vinInvention/Agro-Smart-Hub/docs/Engineering_Reflection.md

# Engineering Reflection

Project: Agro-Smart Hub

---

# Introduction

The Agro-Smart Hub project was the most ambitious engineering project I had undertaken at the time of its development. It required me to combine concepts from mechanical engineering, electrical engineering, embedded systems, renewable energy, software development, and project management into a single working prototype.

Beyond building a functional system, the project challenged me to think like an engineer: identifying problems, evaluating alternatives, testing solutions, and continuously improving the design.

---

# Systems Thinking

One of the most significant lessons from this project was learning to view the prototype as a complete system rather than as individual components.

Although each subsystem could be designed and tested independently, their successful integration depended on careful consideration of how power, communication, mechanical motion, and material flow interacted with one another. This reinforced the importance of designing interfaces between subsystems rather than focusing solely on the performance of individual parts.

---

# Engineering Design

Throughout the project, I learned that engineering design is an iterative process.

Many of the initial ideas changed as new constraints emerged during construction and testing. Rather than viewing these changes as failures, I came to appreciate iteration as an essential part of engineering practice.

Each design revision improved either the reliability, manufacturability, or functionality of the prototype.

---

# Problem Solving

Several technical challenges required careful analysis before solutions could be implemented.

Rather than replacing components immediately when problems occurred, I learned the importance of systematic troubleshooting through observation, testing, and elimination of possible causes.

This approach proved valuable in resolving both mechanical and software-related issues throughout the project.

---

# Interdisciplinary Engineering

The Agro-Smart Hub reinforced my appreciation for interdisciplinary engineering.

Mechanical components depended on electrical power systems, electrical hardware depended on embedded software, and software decisions directly influenced mechanical behaviour.

Working across these disciplines strengthened my understanding of how mechatronic systems integrate multiple engineering fields into a unified solution.

---

# Leadership and Mentorship

Developing the project alongside secondary school students required balancing technical responsibilities with teaching and mentorship.

Breaking the project into manageable subsystems allowed students to understand complex engineering concepts while contributing meaningfully to the construction and testing of the prototype.

This experience strengthened my ability to communicate technical ideas clearly and to guide a multidisciplinary team toward a shared objective.

---

# Project Management

The project highlighted the importance of planning, budgeting, documentation, procurement, scheduling, and risk management.

Unexpected challenges frequently required adjustments to the original plan, reinforcing the need for flexibility while maintaining focus on the overall project objectives.

---

# Resilience

Not every challenge encountered during the project had a technical cause.

Equipment loss, component failures, and time constraints affected progress and required continual adaptation.

These experiences reinforced the importance of resilience, preparation, and maintaining progress despite unforeseen setbacks.

---

# Future Development

If I were to redesign the Agro-Smart Hub, I would focus on improving system reliability, modularity, and maintainability.

Potential improvements include enhanced battery management, closed-loop control using sensors, improved wireless communication, autonomous operation, and computer vision for process monitoring.

---

# Conclusion

The Agro-Smart Hub project transformed my understanding of engineering from assembling individual components to designing integrated systems that solve real-world problems.

More importantly, it strengthened my confidence in approaching unfamiliar engineering challenges through structured analysis, experimentation, and continuous improvement. The experience has further motivated me to pursue advanced studies in mechatronics engineering, where I hope to deepen my knowledge and contribute to the development of intelligent engineering systems.
