vinInvention/Agro-Smart-Hub/assets/truck/Truck and L293D Motor driver  connection.pdf

Here are images on how to connect your motor to the motor driver shield

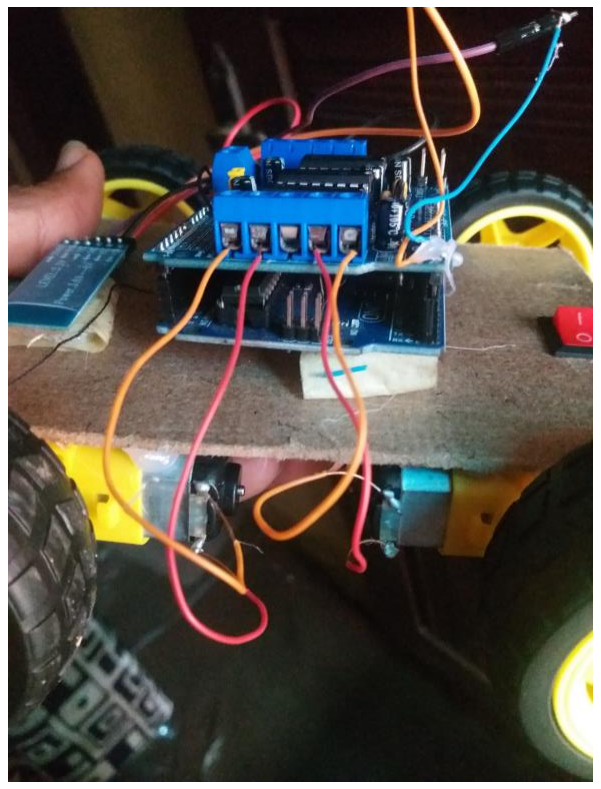
[picture p23: figure]
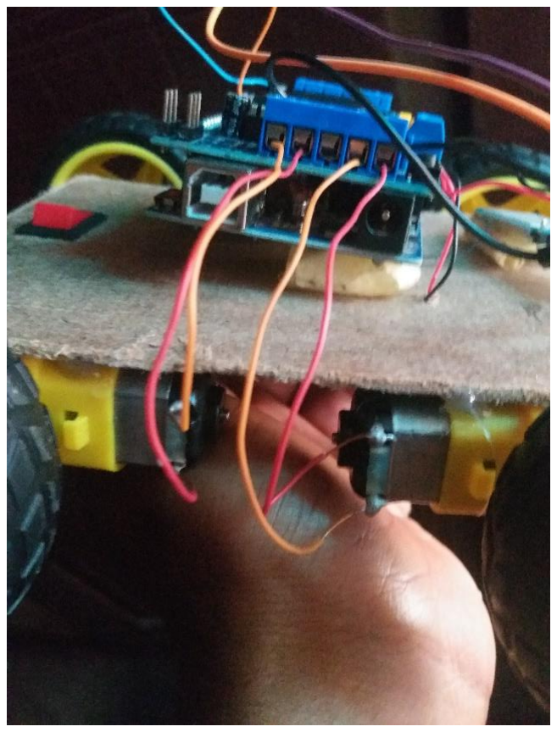
[picture p24: figure]

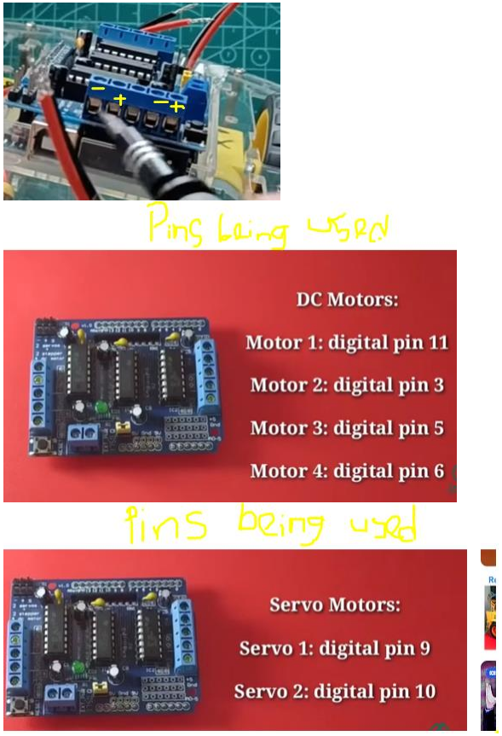
[picture p25: figure]

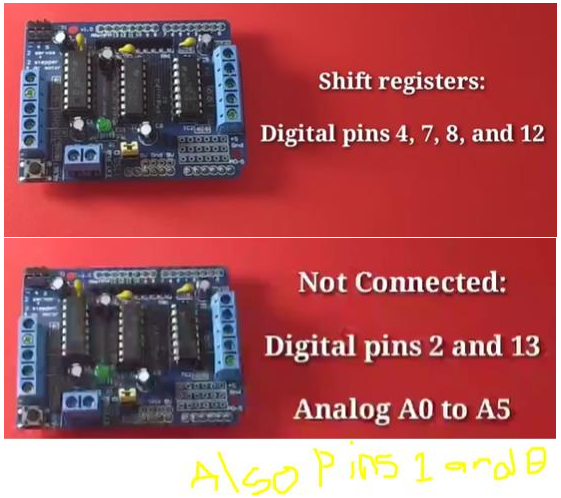
[picture p26: figure]
