vinInvention/Agro-Smart-Hub/assets/2. Units built.jpg

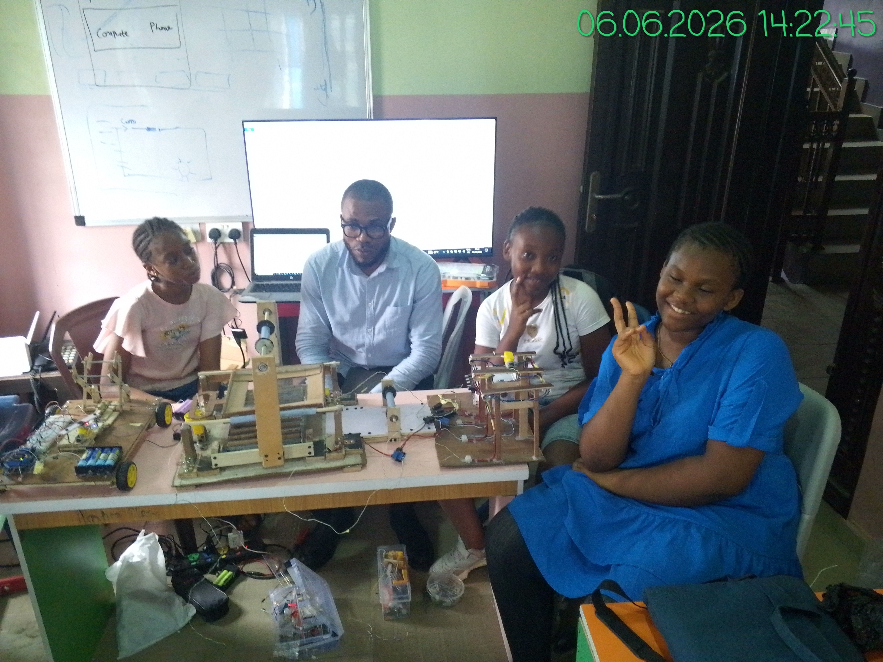
assets/2. Units built.jpg
