vinInvention/Agro-Smart-Hub/assets/Assignments for my student/Calculate the power of the load.PNG

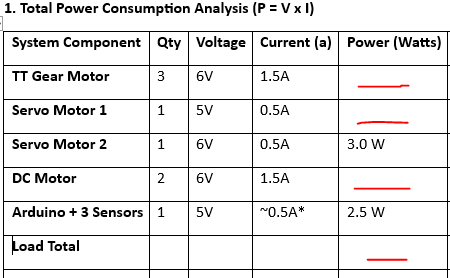
assets/Assignments for my student/Calculate the power of the load.PNG
