vinInvention/Agro-Smart-Hub/assets/Assignments for my student/Know the actuators we would use.png

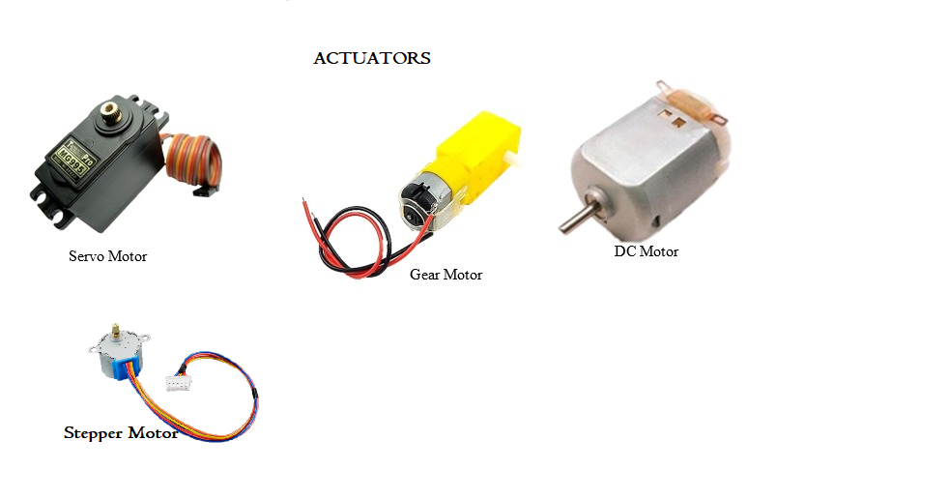
assets/Assignments for my student/Know the actuators we would use.png
