vinInvention/Agro-Smart-Hub/assets/Assignments for my student/What is the total voltage and capacity from this pack.PNG

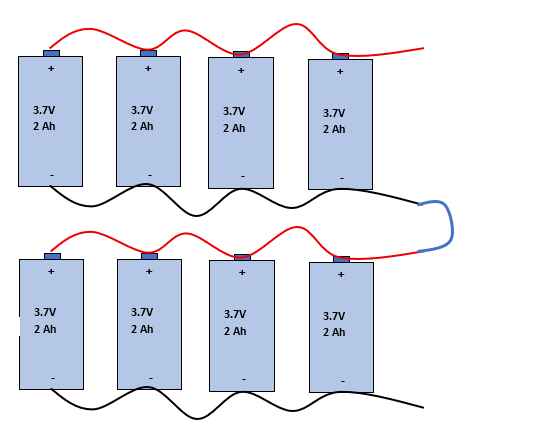
assets/Assignments for my student/What is the total voltage and capacity from this pack.PNG
