vinInvention/Agro-Smart-Hub/assets/Assignments for my student/What should be in the dashes parallel.PNG

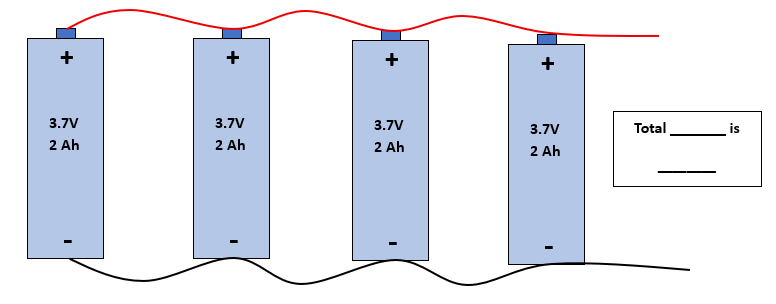
assets/Assignments for my student/What should be in the dashes parallel.PNG
