vinInvention/Agro-Smart-Hub/assets/Assignments for my student/What should be in the dashes.PNG

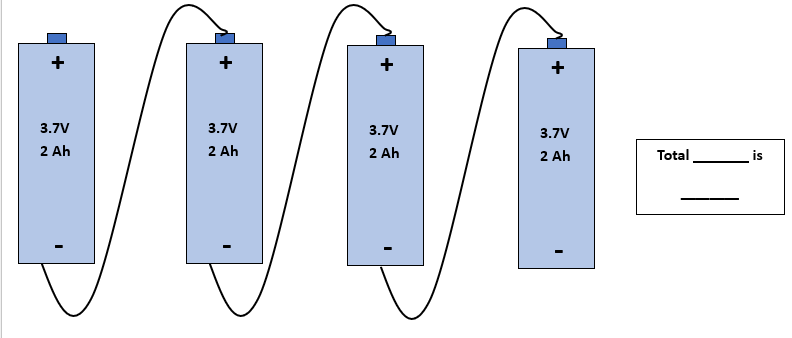
assets/Assignments for my student/What should be in the dashes.PNG
