vinInvention/Agro-Smart-Hub/assets/Battery pack/2. Battery arragement.jpeg

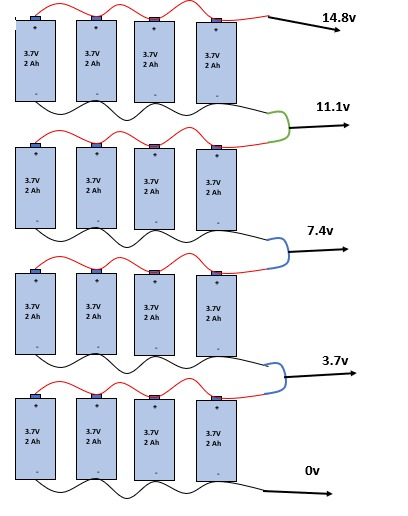
assets/Battery pack/2. Battery arragement.jpeg
