vinInvention/Agro-Smart-Hub/assets/Battery pack/4. Battery pack.jpeg

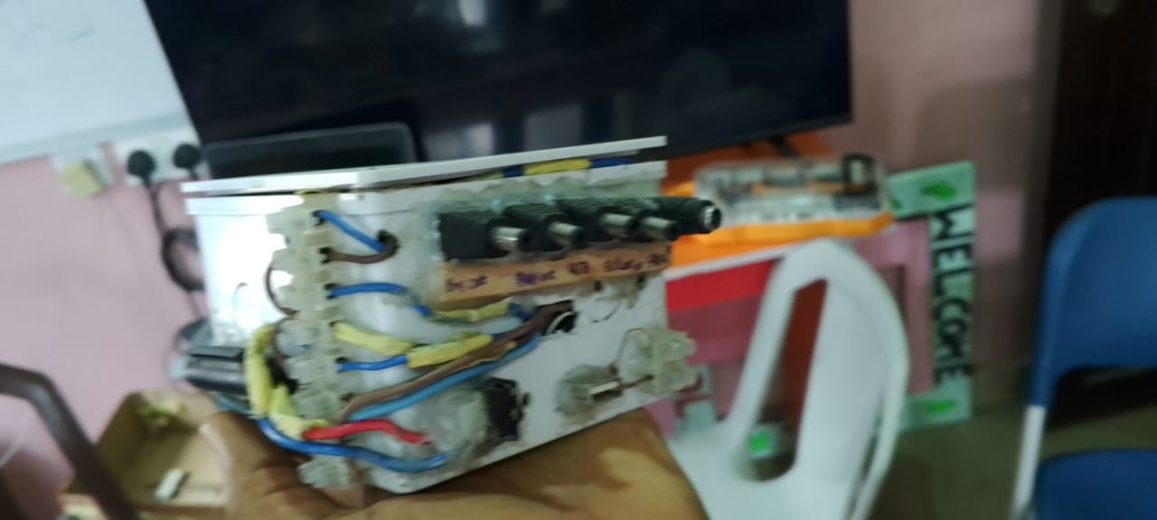
assets/Battery pack/4. Battery pack.jpeg
