vinInvention/Agro-Smart-Hub/assets/Cassava lift mechanism/01 Linkage before modification.jpg

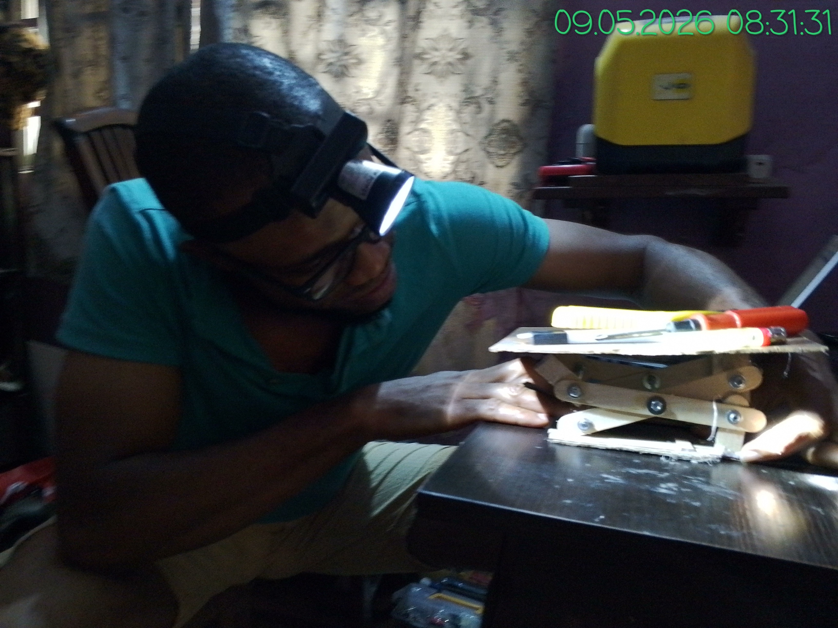
assets/Cassava lift mechanism/01 Linkage before modification.jpg
