vinInvention/Agro-Smart-Hub/assets/Cassava lift mechanism/02 Linkage before modification.jpg

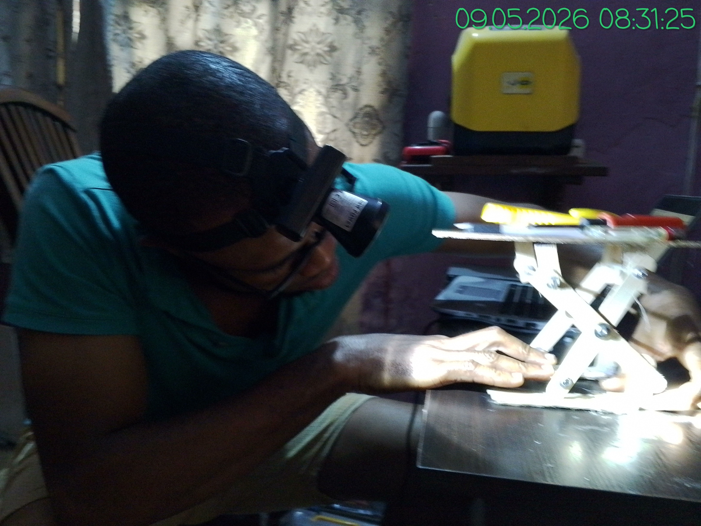
assets/Cassava lift mechanism/02 Linkage before modification.jpg
