vinInvention/Agro-Smart-Hub/assets/Cassava lift mechanism/03 Linkage before modification.jpg

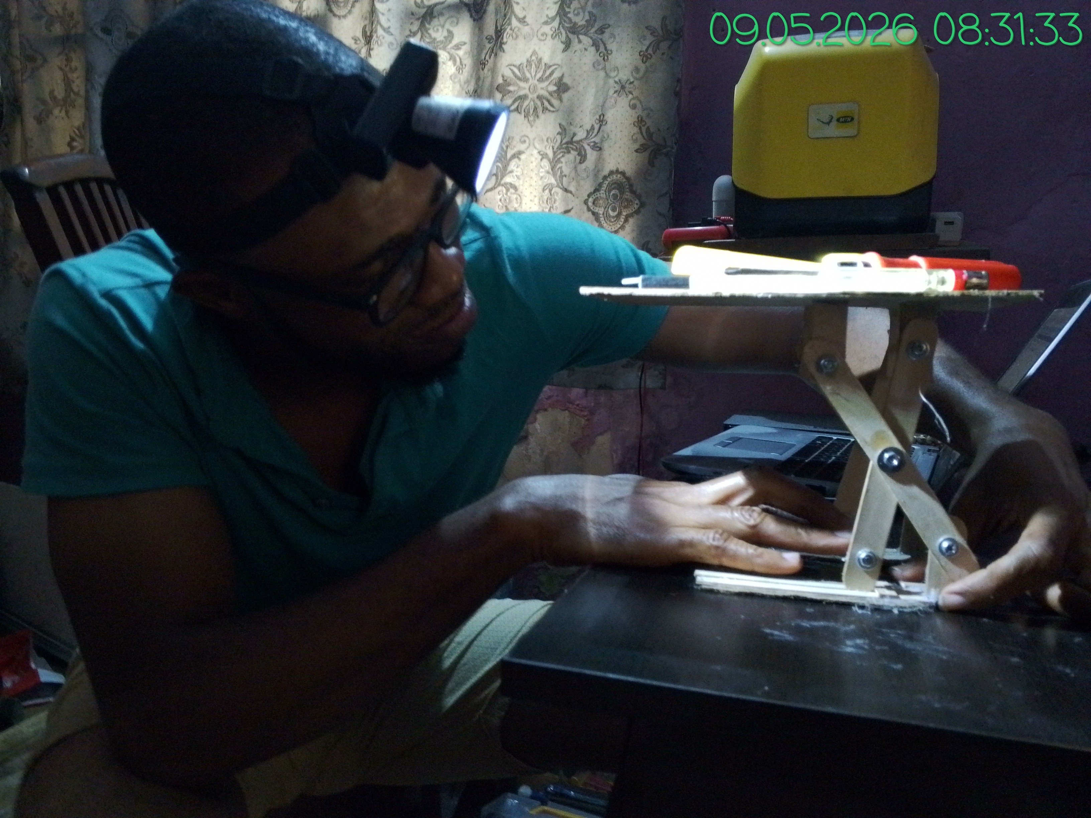
assets/Cassava lift mechanism/03 Linkage before modification.jpg
