vinInvention/Agro-Smart-Hub/assets/Power station/1. Power distribution diagram (Hand drawn).jpeg

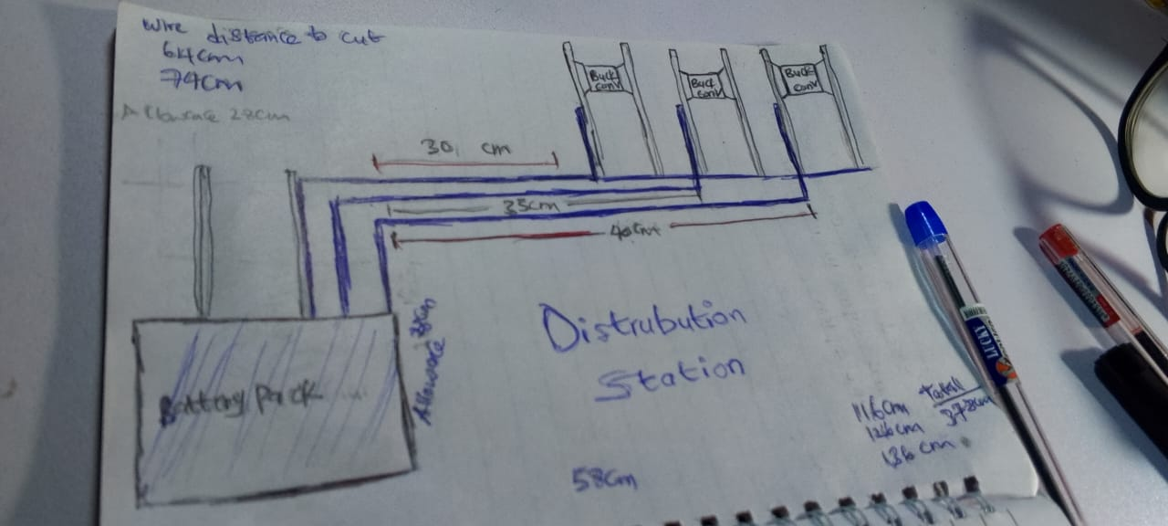
assets/Power station/1. Power distribution diagram (Hand drawn).jpeg
