vinInvention/Agro-Smart-Hub/assets/Power station/5. Power grid completed.jpg

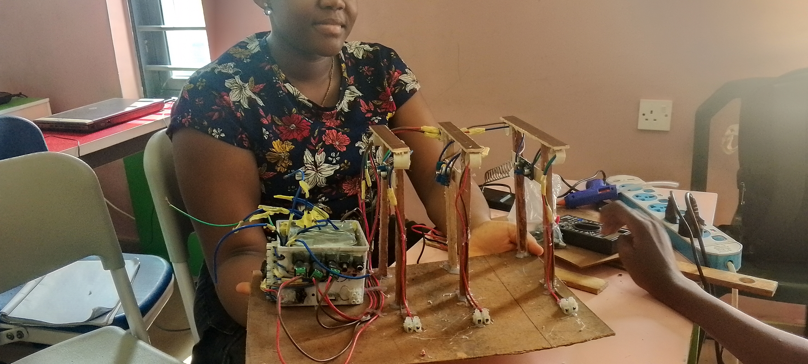
assets/Power station/5. Power grid completed.jpg
