vinInvention/Agro-Smart-Hub/assets/Semi finals certicate.PNG

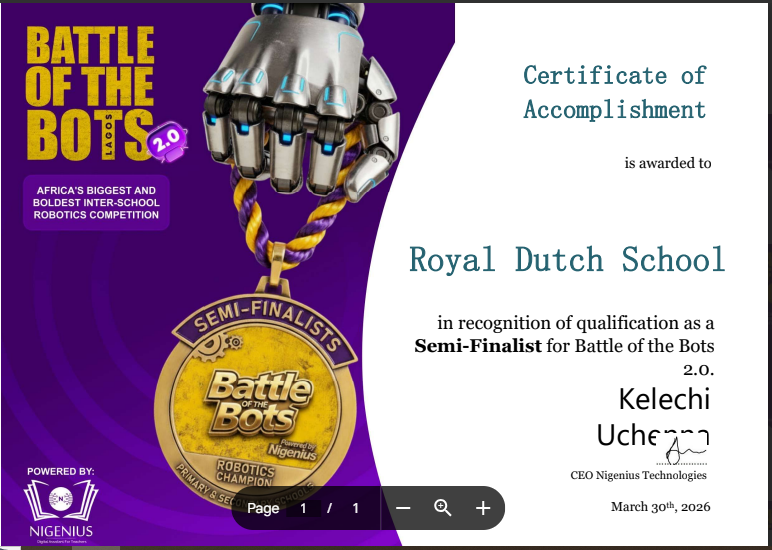
assets/Semi finals certicate.PNG
