vinInvention/Agro-Smart-Hub/assets/Sieving hub/3. Sieving hub and truck.jpeg

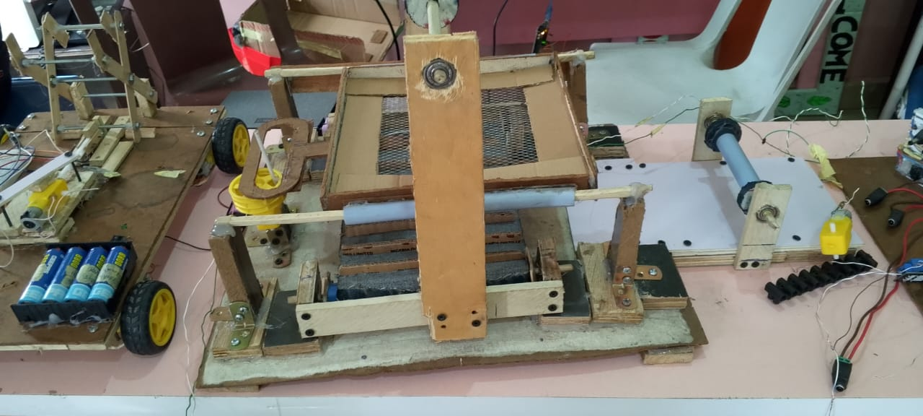
assets/Sieving hub/3. Sieving hub and truck.jpeg
