vinInvention/Agro-Smart-Hub/assets/Simulation of H-bridge circuit to control Rack and pinion/H-bridge circuit diagram (Hand drawn).jpeg

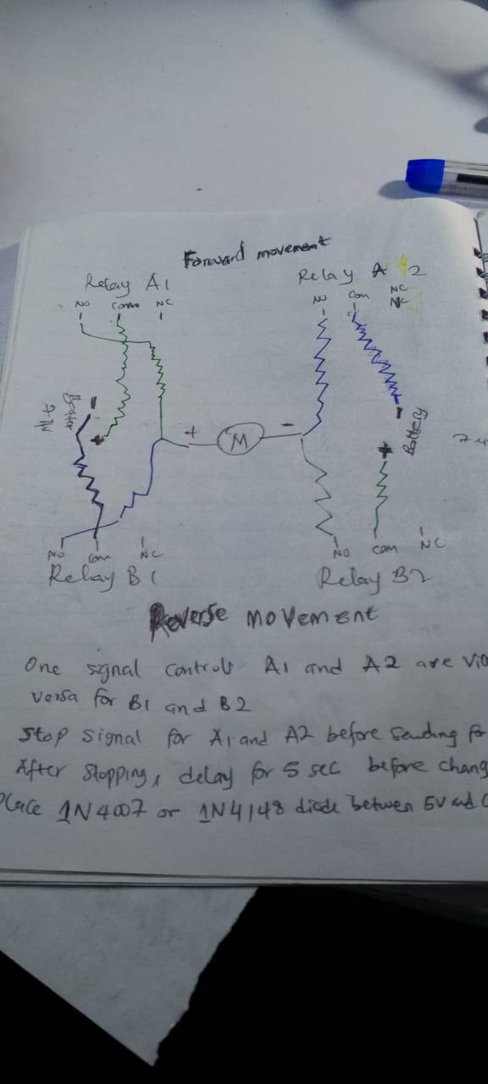
assets/Simulation of H-bridge circuit to control Rack and pinion/H-bridge circuit diagram (Hand drawn).jpeg
