vinInvention/Agro-Smart-Hub/assets/Slanting Conveyor/Slant conveyor.PNG

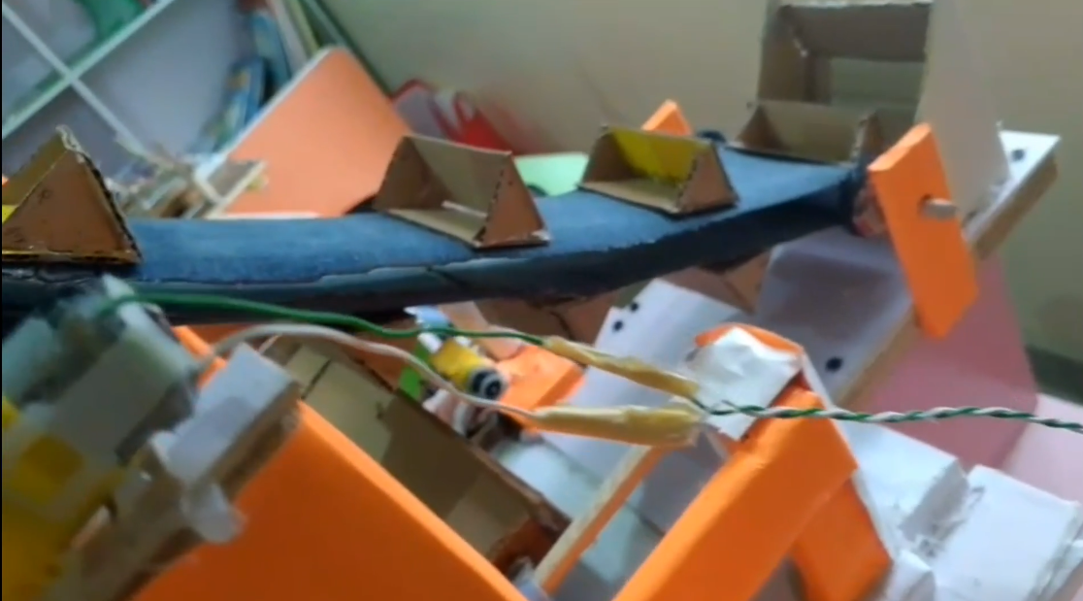
assets/Slanting Conveyor/Slant conveyor.PNG
