vinInvention/Agro-Smart-Hub/assets/truck/1. Structure and support.png

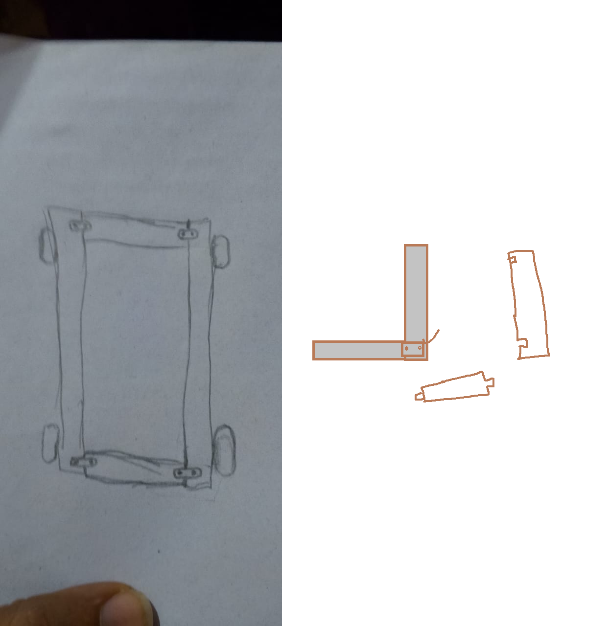
assets/truck/1. Structure and support.png
