vinInvention/Agro-Smart-Hub/assets/truck/2. Measuring beam for truck frame.jpg

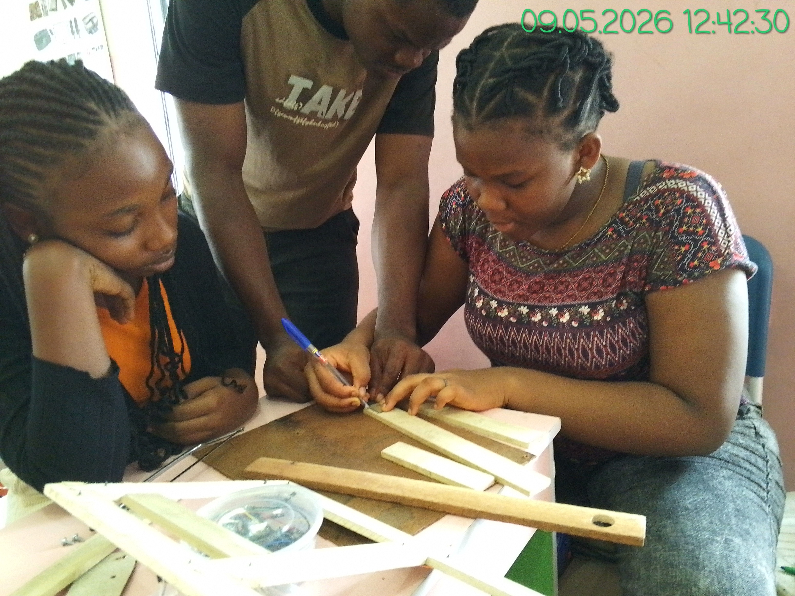
assets/truck/2. Measuring beam for truck frame.jpg
