vinInvention/Agro-Smart-Hub/assets/truck/3. Measuring beam for truck frame.jpg

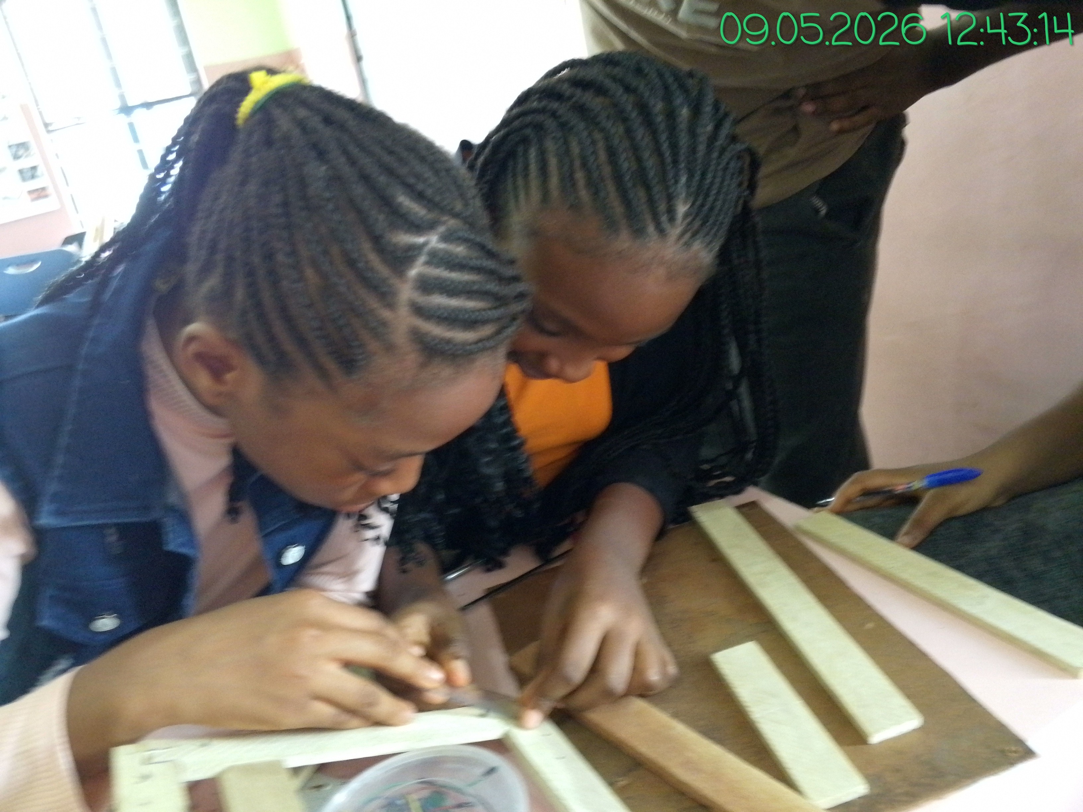
assets/truck/3. Measuring beam for truck frame.jpg
