vinInvention/Agro-Smart-Hub/assets/truck/7. Attaching wheels.jpg

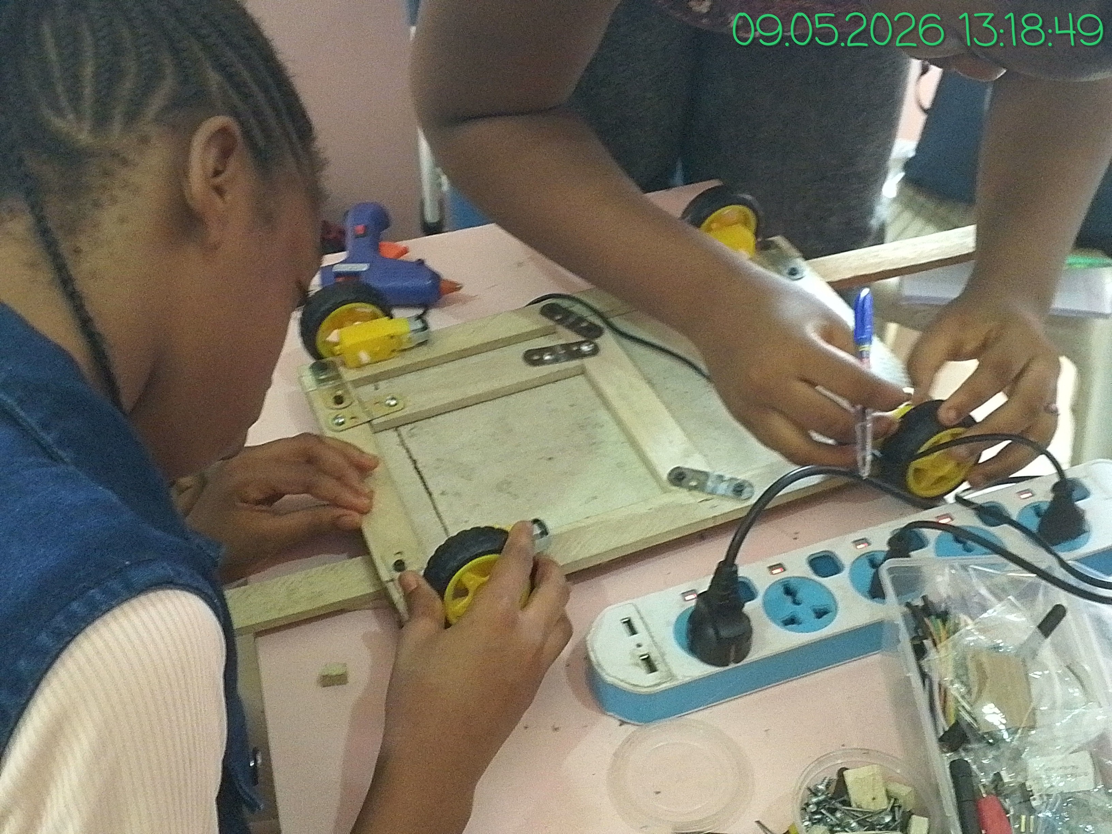
assets/truck/7. Attaching wheels.jpg
