vinInvention/Agro-Smart-Hub/assets/truck/8. Attaching wheels to frame.jpg

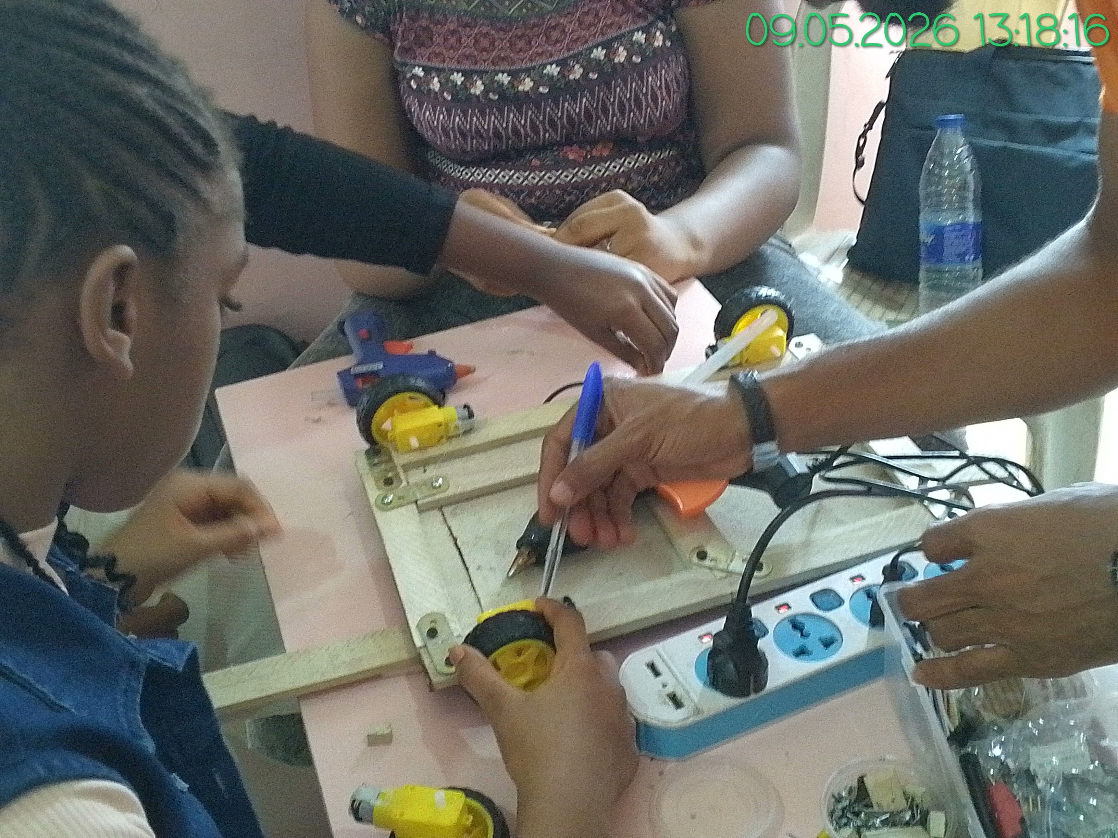
assets/truck/8. Attaching wheels to frame.jpg
