vinInvention/Agro-Smart-Hub/assets/truck/9. Wheels attached.jpg

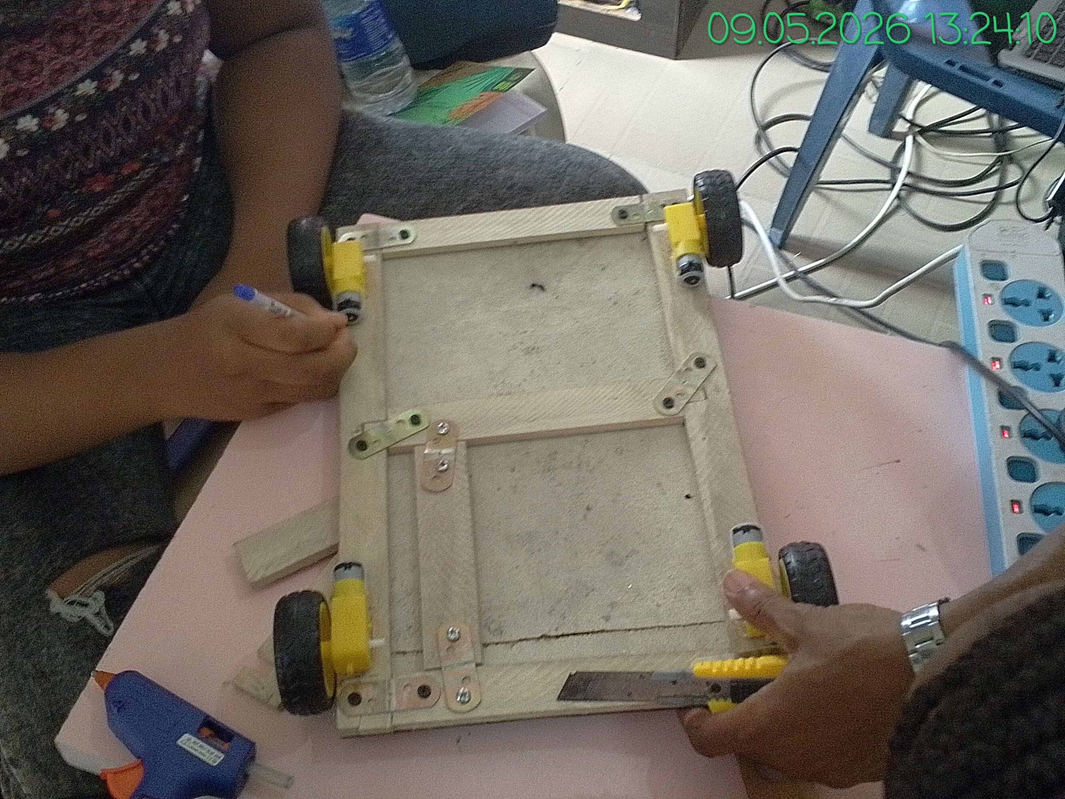
assets/truck/9. Wheels attached.jpg
