vinInvention/Agro-Smart-Hub/assets/truck/9a. Wheels attached.jpg

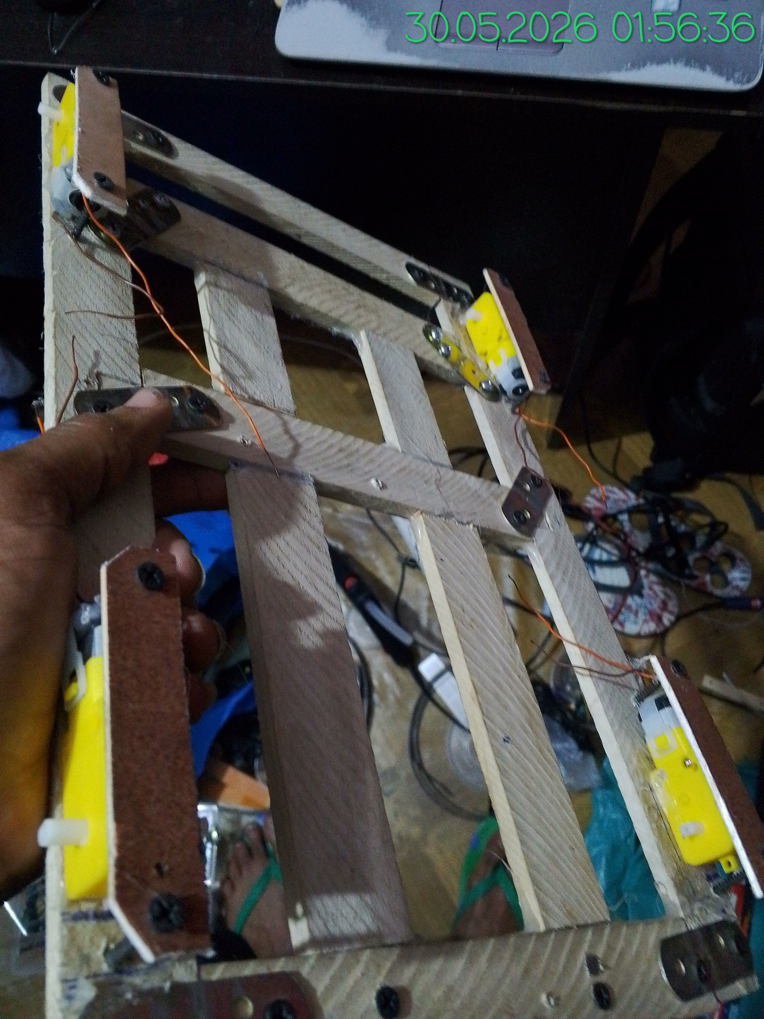
assets/truck/9a. Wheels attached.jpg
