vinInvention/Agro-Smart-Hub/docs/Manufacturing_Drawings_and_Dimensions.md

# Manufacturing Drawings and Dimensions

Project: Agro-Smart Hub

---

# Purpose

This document provides an index of the manufacturing drawings and dimensional information developed for the Agro-Smart Hub prototype.

The prototype was fabricated primarily from plywood, ceiling board, PVC pipes, steel shafts, bearings, and custom-built mechanisms. Due to the iterative nature of the prototype development, not all component dimensions were formally documented during fabrication.

The drawings referenced below illustrate the construction and layout of the major subsystems.

---

# Available Drawings

| Drawing | Description | Location |
| --- | --- | --- |
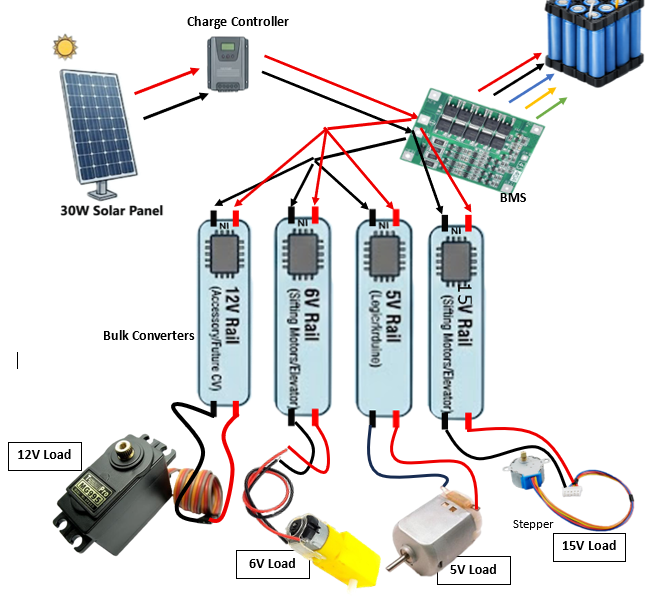
[picture p51: assets/Power station/1. Solar power station diagram.PNG]
Power Station
| Renewable Power Station | Power station layout |  |
| Truck Controller | Truck wiring and control | Truck System Wiring |
| Hub Controller | Hub wiring and control | Sieving Hub Wiring |
| Bluetooth Network | Communication architecture | Bluetooth  |

---

# Mechanical Assemblies

The following assemblies were fabricated during the project:

- Renewable Power Station
- Slant Conveyor
- Siever
- Flat Conveyor
- Transport Truck
- Carrier Lift Mechanism

Photographs and supporting media for each assembly are available in the corresponding asset folders.

---

# Notes

The Agro-Smart Hub was developed as an iterative engineering prototype. During fabrication, component dimensions were adjusted as required to achieve proper alignment, motion, and subsystem integration. Where available, measured dimensions may be added in future revisions.
