vinInvention/Agro-Smart-Hub/assets/Power station/Electrical wiring diagram.txt

           			    +-------------------------------------------------+

                                    |               80W SOLAR PANEL                   |
                                    |        (Outputs ~19V Peak / 4.21A Max)          |
                                    +-----------------------+-------------------------+

                                                            |         |
                                                           (+)       (-)

                                                            |         |
                                                            v         v
                                    +-----------------------+-------------------------+

                                    |              XL4016 BUCK CONVERTER              |
                                    |                                                 |
                                    |   [IN+]                                 [IN-]   |
                                    |     |                                     |     |
                 (19V Input From Panel) --+                                     +-- (Ground)

                                    |                                                 |
                                    |     [CC Pot]                   [CV Pot]         |
                                    |   (Set to 2.25A)             (Set to 17.2V)     |
                                    |                                                 |
                                    |   [OUT+]                                [OUT-]  |
                                    +-----+-------------------------------------+-----+

                                          |                                     |
                                          |                                     |
                                          v                                     |
                                   [ 5A INLINE FUSE ]                           |

                                          |                                     |
                                          v                                     |
                                   [ SCHOTTKY DIODE ]                           |
                                   (10SQ045 / 10SQ050)                          |
                              Anode ( | )  Cathode ( |>| )                      |

                                          |                                     |
                                          | (-0.4V Drop leaves exactly 16.8V)   |
                                          |                                     |
                                          v                                     v
                                    +-----+-------------------------------------+-----+

                                    |         4S LITHIUM-ION BATTERY BMS        |
                                    |          (Battery Management System)            |
                                    |                                                 |
                                    |   [B+ / P+]                             [B- / P-]   |
                                    +-----+-------------------------------------+-----+

                                          |                                     |
                                          +-----------------+                   |

                                                            |                   |
                                                            v                   v
                                                      +-----+-------------------+-----+

                                                      |          SYSTEM LOAD          |
                                                      |    (Appliances / Devices)     |
                                                      +-------------------------------+
