vinInvention/Agro-Smart-Hub/assets/3. Entire setup.jpeg

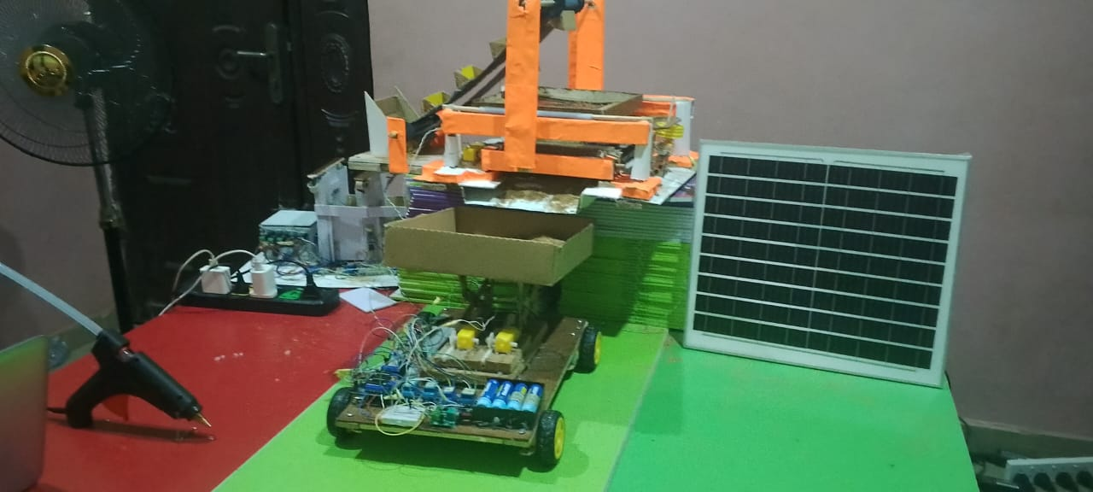
assets/3. Entire setup.jpeg
