vinInvention/Agro-Smart-Hub/assets/Battery pack/3a.  BatteryPack building.jpg

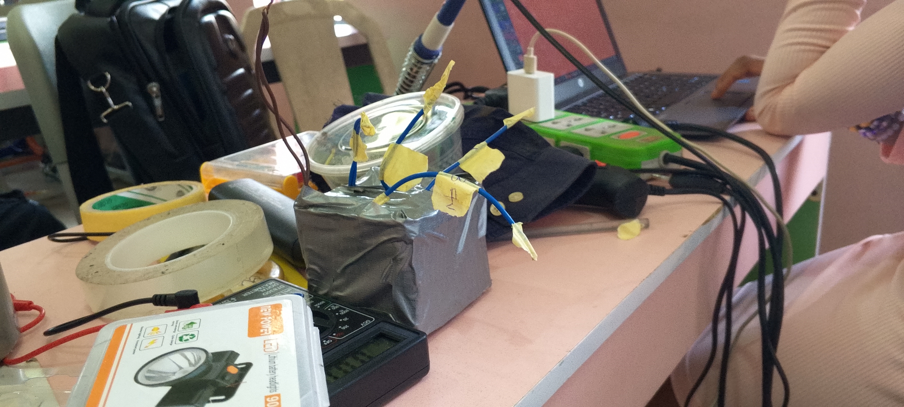
assets/Battery pack/3a. BatteryPack building.jpg
