vinInvention/Agro-Smart-Hub/assets/Flat conveyor with Siever construction/1. Building Flat conveyor.jpg

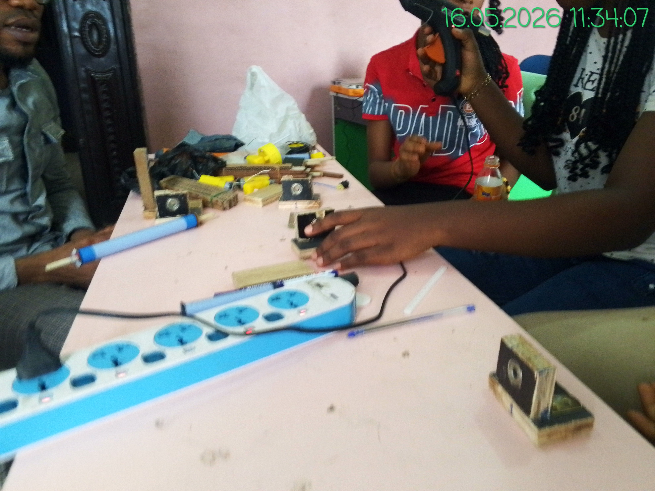
assets/Flat conveyor with Siever construction/1. Building Flat conveyor.jpg
