vinInvention/Agro-Smart-Hub/assets/Flat conveyor with Siever construction/2. Building Flat conveyor.jpg

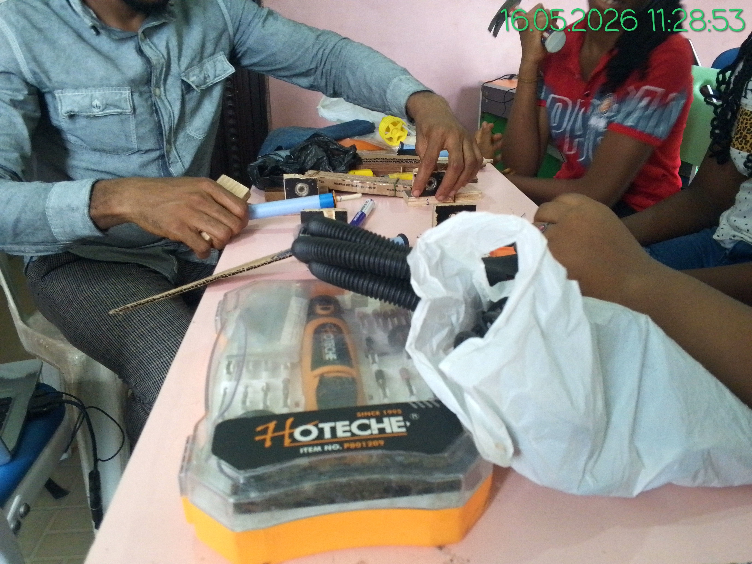
assets/Flat conveyor with Siever construction/2. Building Flat conveyor.jpg
