vinInvention/Agro-Smart-Hub/assets/Flat conveyor with Siever construction/3. Building Flat conveyor.jpg

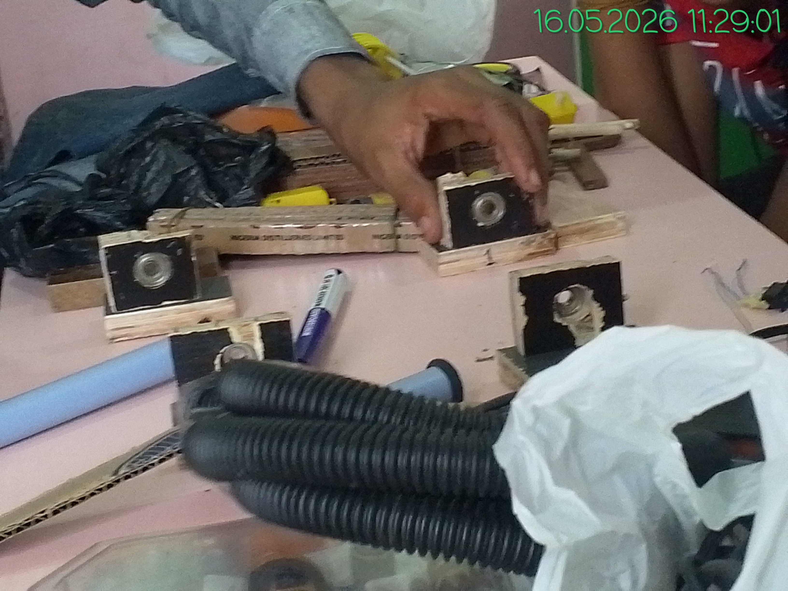
assets/Flat conveyor with Siever construction/3. Building Flat conveyor.jpg
