vinInvention/Agro-Smart-Hub/assets/Power station/2. Constructing the power grid.jpg

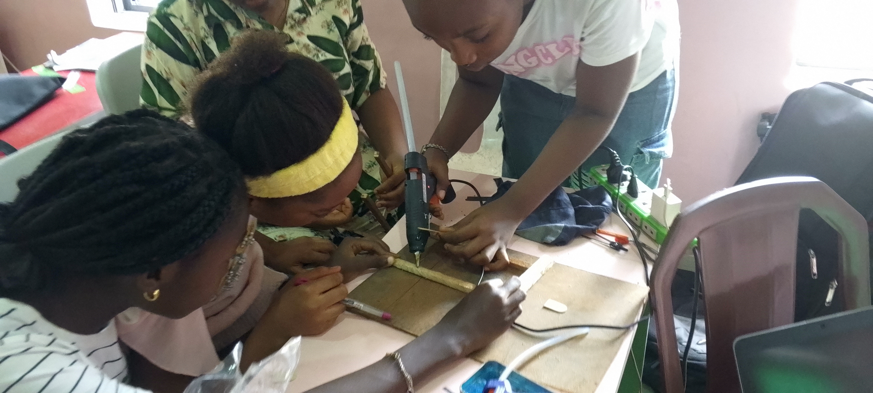
assets/Power station/2. Constructing the power grid.jpg
