vinInvention/Agro-Smart-Hub/assets/Power station/3. Constructing the power grid.jpg

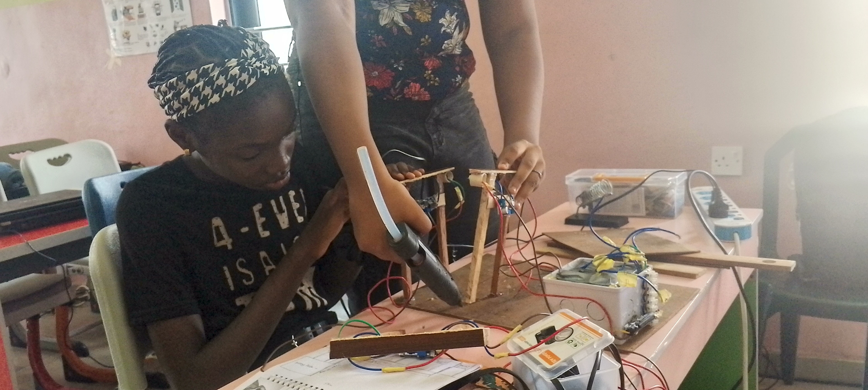
assets/Power station/3. Constructing the power grid.jpg
