vinInvention/Agro-Smart-Hub/assets/Power station/4. Constructing the power grid.jpg

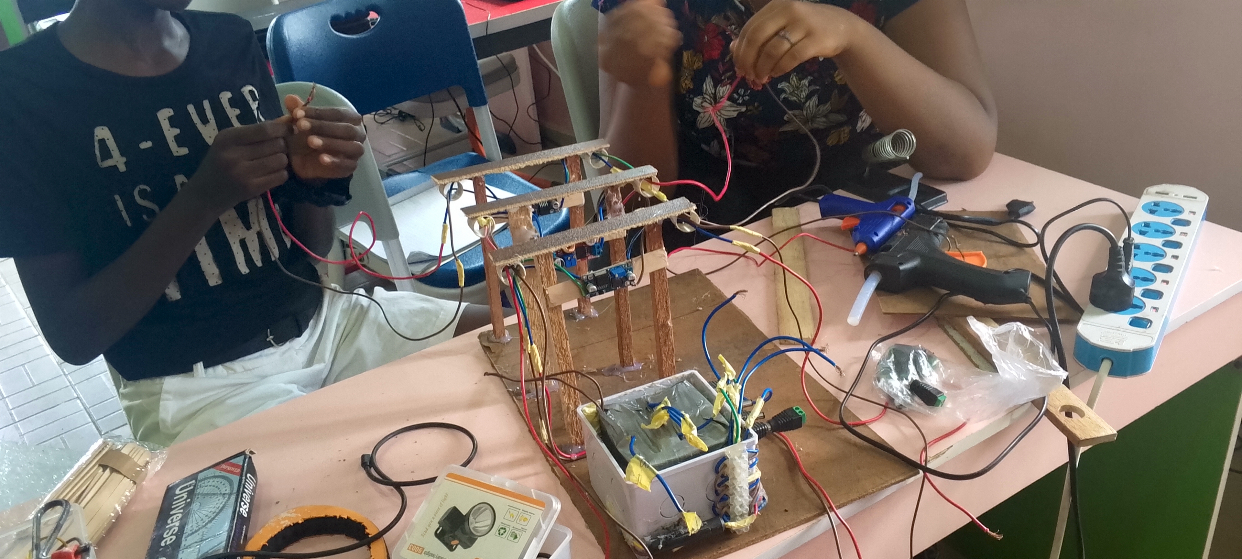
assets/Power station/4. Constructing the power grid.jpg
