vinInvention/Agro-Smart-Hub/(list of files, drawings)

Other design files:
assets/Simulation of H-bridge circuit to control Rack and pinion/H-bridge with relay.pdsprj
assets/Simulation of H-bridge circuit to control Rack and pinion/Project Backups/H-bridge with relay [20260614, 08-35-59].pdsprj
assets/Simulation of H-bridge circuit to control Rack and pinion/Project Backups/H-bridge with relay [20260614, 08-38-07].pdsprj
assets/Simulation of H-bridge circuit to control Rack and pinion/Project Backups/H-bridge with relay [20260614, 08-40-14].pdsprj
assets/Simulation of H-bridge circuit to control Rack and pinion/Project Backups/H-bridge with relay [20260614, 08-41-31].pdsprj
assets/Simulation of H-bridge circuit to control Rack and pinion/Project Backups/H-bridge with relay [20260614, 08-43-44].pdsprj
assets/Simulation of H-bridge circuit to control Rack and pinion/Project Backups/H-bridge with relay [20260614, 09-29-10].pdsprj
assets/Simulation of H-bridge circuit to control Rack and pinion/Project Backups/H-bridge with relay [20260614, 09-29-56].pdsprj
