vinInvention/Agro-Smart-Hub/(commit log)

2026-07-24 Add Renewable Power System documentation
2026-07-24 Add Communication System documentation, Add files to asset directory
    [H-bridge with relay [20260614, 08-35-59].pdsprj, H-bridge with relay [20260614, 08-38-07].pdsprj, H-bridge with relay [20260614, 08-40-14].pdsprj, H-bridge with relay [20260614, 08-41-31].pdsprj, H-bridge with relay [20260614, 08-43-44].pdsprj, H-bridge with relay [20260614, 09-29-10].pdsprj, H-bridge with relay [20260614, 09-29-56].pdsprj, H-bridge with relay.pdsprj]
2026-07-25 Add Bill of Materials (BOM)
2026-08-01 Add truck and hub wiring diagrams and controller pinouts
